functional-neuroimaging/Universal_Headframe/cad/NT_NCS002_001_P_004.stp

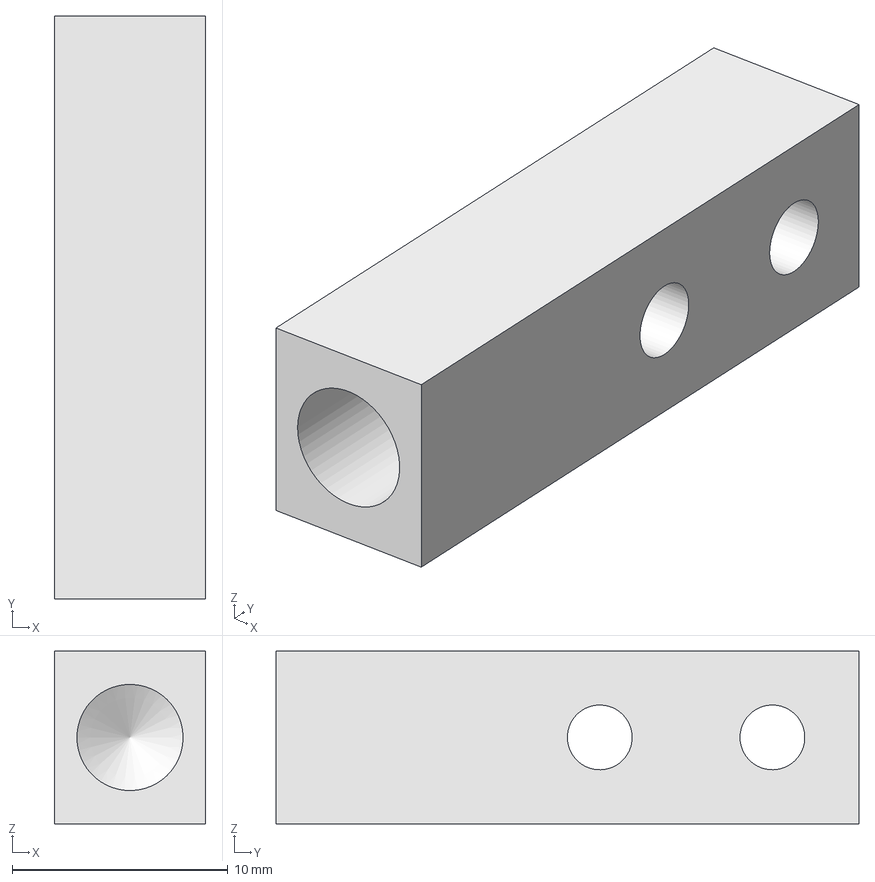
[picture p1: CAD file, 2025-04-28]
cad/NT_NCS002_001_P_004.stp
7.00 x 27.0 x 8.00 mm
