functional-neuroimaging/Universal_Headframe/drawings/NT_NCS002_001_P_004.pdf

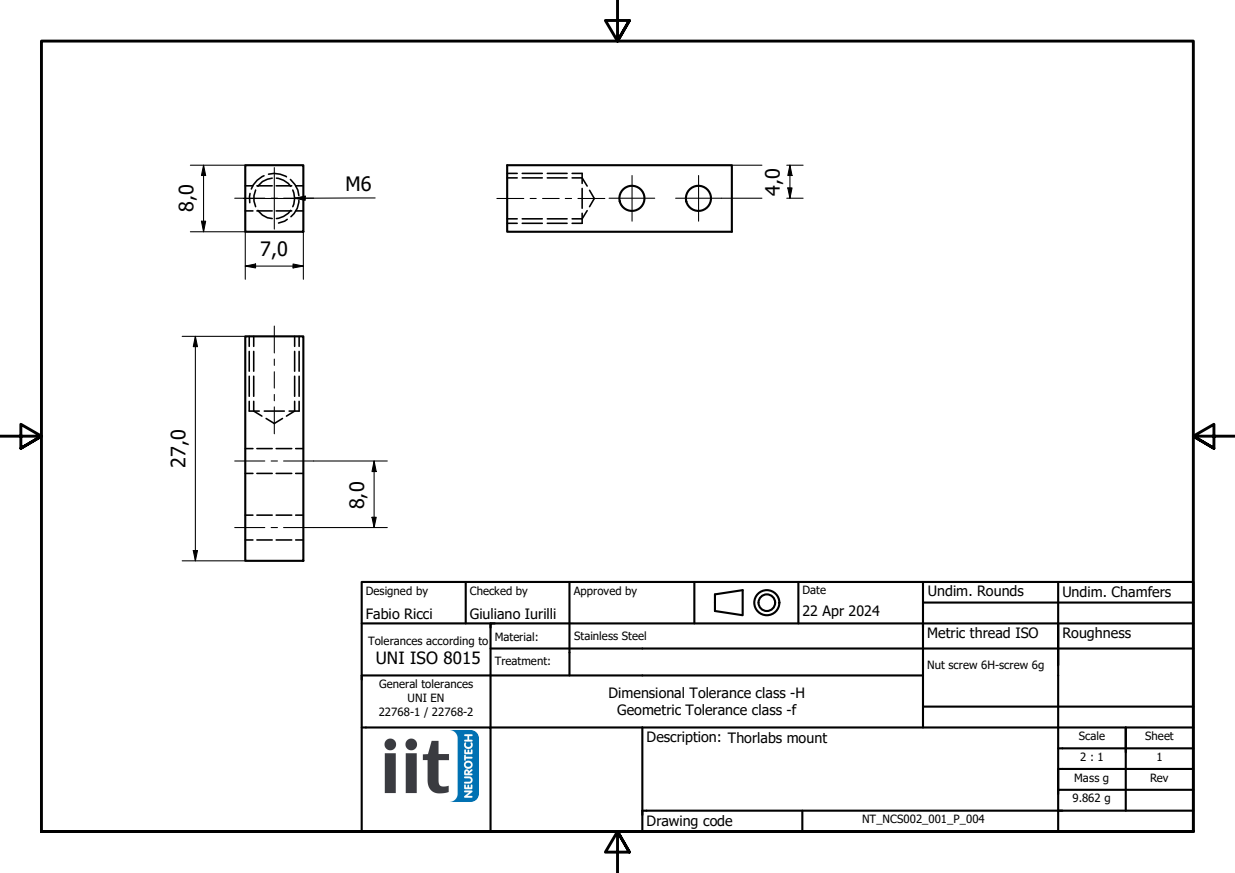
[picture p1: page 1]
Fabio Ricci; Giuliano Iurilli; 22 Apr 2024; Designed by; Checked by; Approved by; Date; Undim. Rounds; Undim. Chamfers

Tolerances according to UNI ISO 8015 | Material: | Stainless Steel | Metric thread ISO | Roughness

Treatment: | | Nut screw 6H-screw 6g

General tolerances UNI EN 22768-1 / 22768-2 | Dimensional Tolerance class -H Geometric Tolerance class -f

Description: Thorlabs mount | Scale | Sheet

Mass g | Rev
9.862 g

Drawing code | NT_NCS002_001_P_004
